tro-nic/SondaDiferencial/img/bottom.png

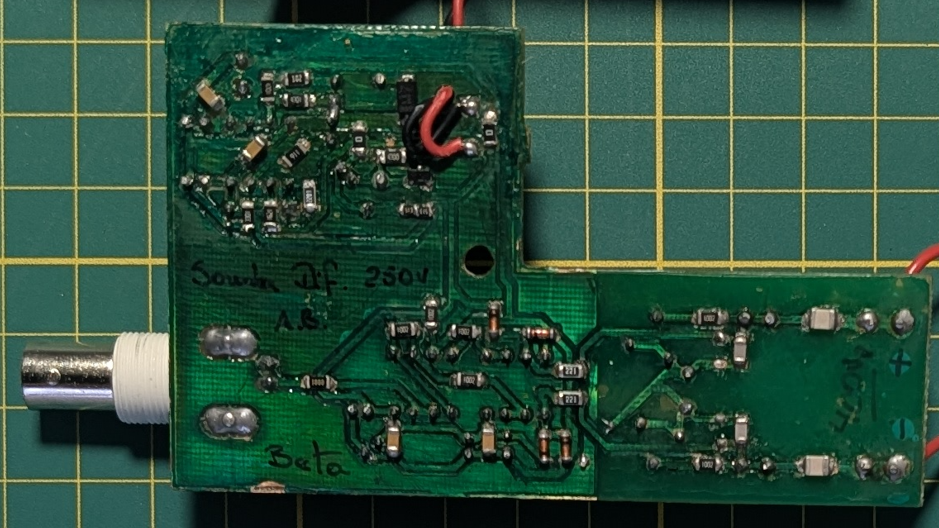
img/bottom.png
