tro-nic/SondaDiferencial/img/Regulador.png

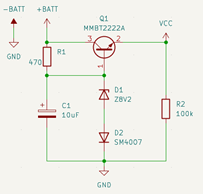
img/Regulador.png
