tro-nic/SondaDiferencial/PCB_KICAD10/sonda_diferencia_v0.kicad_pcb

## KiCad design PCB_KICAD10/sonda_diferencia_v0.kicad_pcb (2026-10-22)

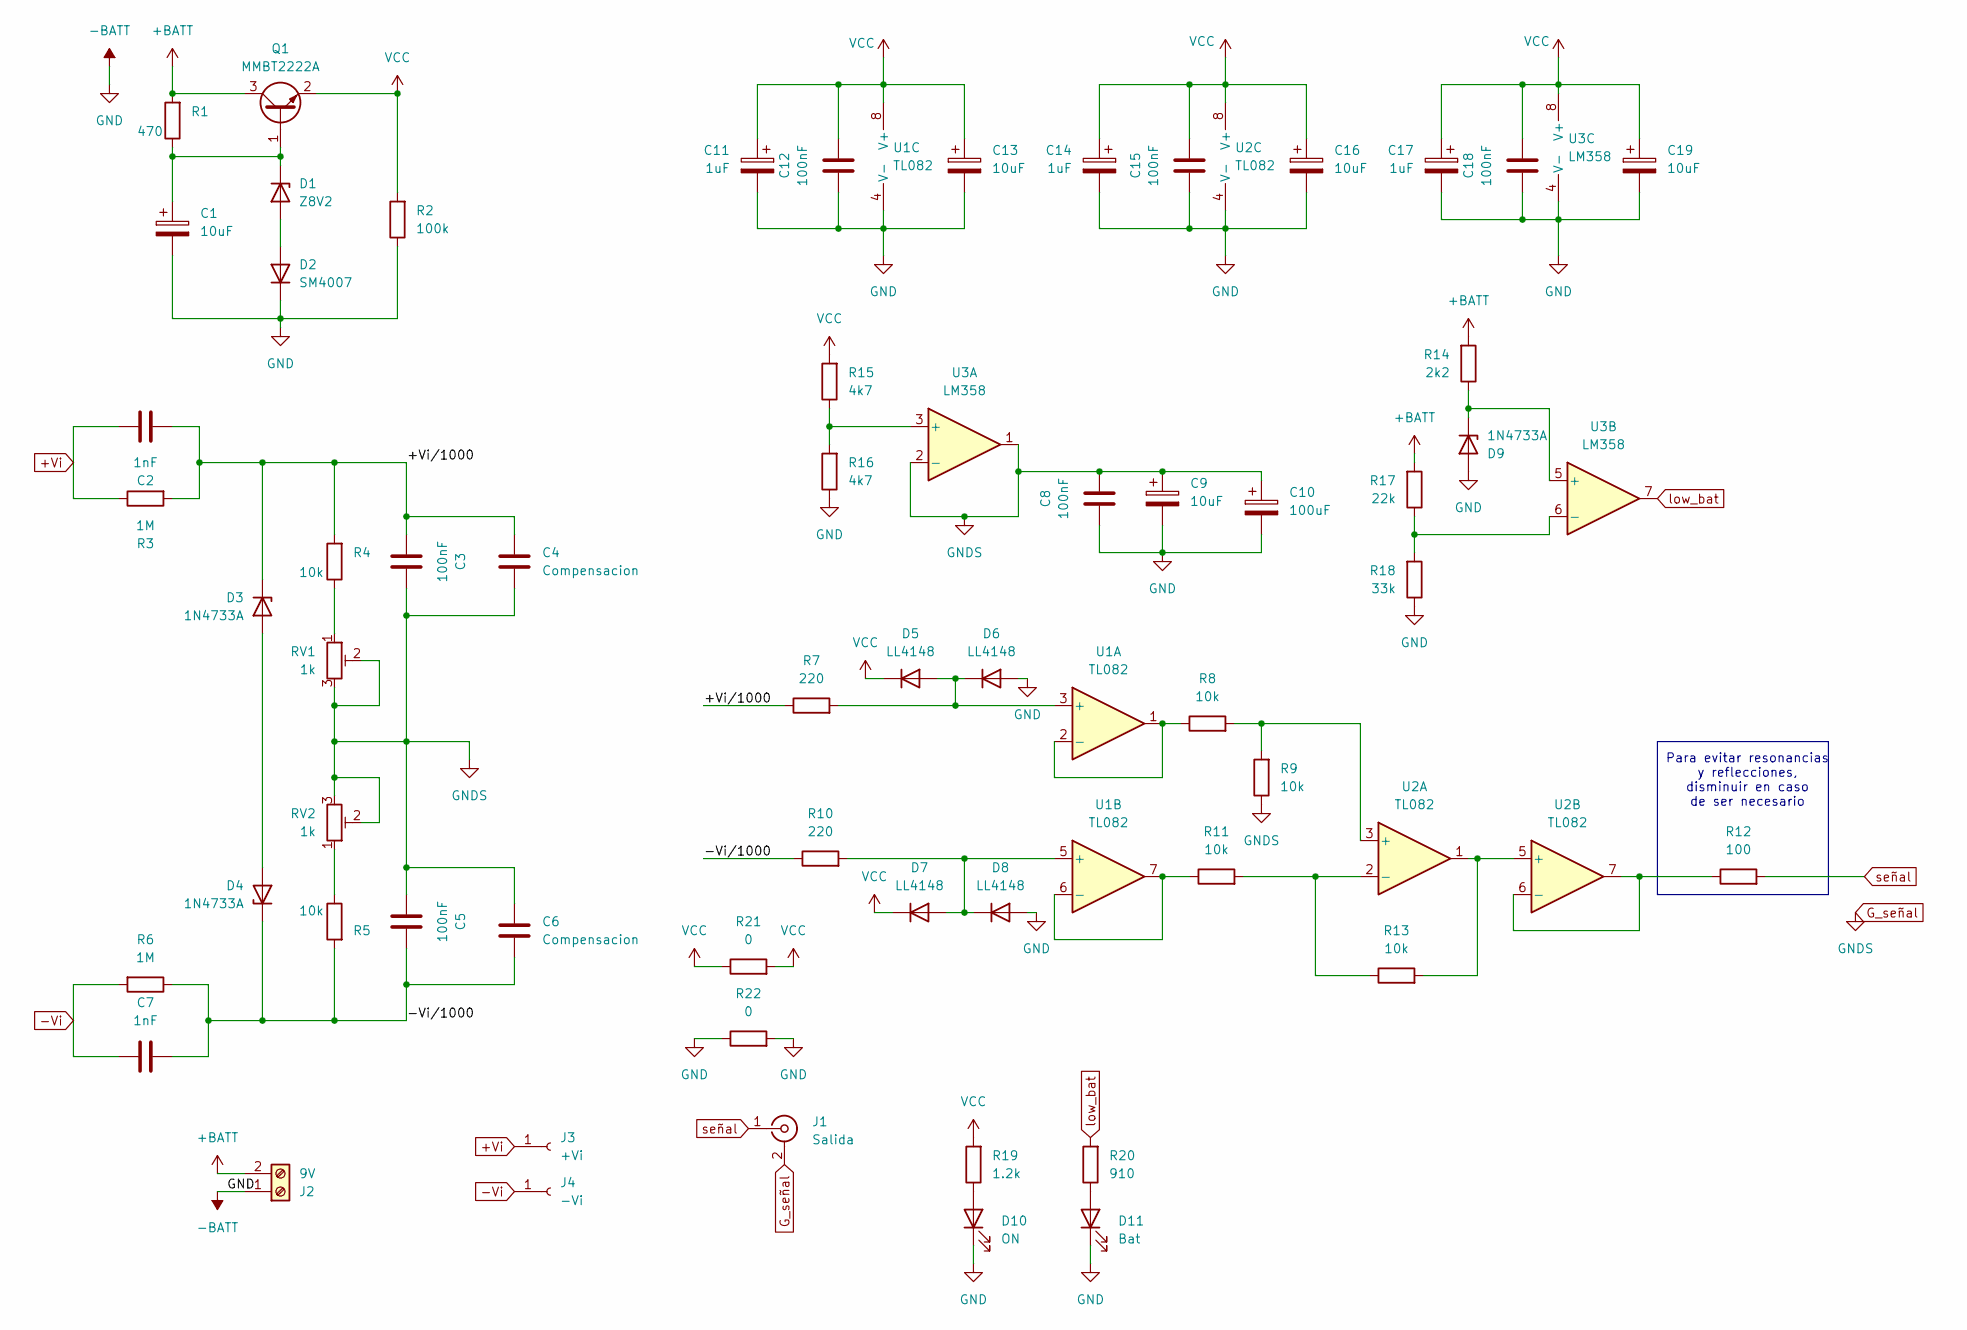
[picture p6: schematic sonda_diferencia_v0.kicad_sch, Sonda activa diferencial (DIY/Lowcost)]

Parts:
C1, C9, C13, C16, C19: 10uF; CP_Radial_D5.0mm_P2.00mm
C2, C7: 1nF; C_1206_3216Metric_Pad1.33x1.80mm_HandSolder
C3, C5, C8, C12, C15, C18: 100nF; C_1206_3216Metric_Pad1.33x1.80mm_HandSolder
C4, C6: Compensacion; C_1206_3216Metric_Pad1.33x1.80mm_HandSolder
C10: 100uF; CP_Radial_D8.0mm_P3.50mm
C11, C14, C17: 1uF; CP_Radial_D4.0mm_P2.00mm
D1: Z8V2; D_DO-41_SOD81_P12.70mm_Horizontal
D2: SM4007; D_MELF
D3, D4, D9: 1N4733A; D_DO-41_SOD81_P10.16mm_Horizontal
D5, D6, D7, D8: LL4148; D_MiniMELF
D10: ON; LED_D3.0mm
D11: Bat; LED_D3.0mm
J1: Salida; BNC_Amphenol_B6252HB-NPP3G-50_Horizontal
J2: 9V; TerminalBlock_MaiXu_MX126-5.0-02P_1x02_P5.00mm
J3: +Vi; PinHeader_1x01_P2.54mm_Vertical
J4: -Vi; PinHeader_1x01_P2.54mm_Vertical
Q1: MMBT2222A; SOT-23
R1: 470; R_1206_3216Metric_Pad1.30x1.75mm_HandSolder
R2: 100k; R_1206_3216Metric_Pad1.30x1.75mm_HandSolder
R3, R6: 1M; R_Axial_DIN0411_L9.9mm_D3.6mm_P12.70mm_Horizontal
R4, R5, R8, R9, R11, R13: 10k; R_1206_3216Metric_Pad1.30x1.75mm_HandSolder
R7, R10: 220; R_1206_3216Metric_Pad1.30x1.75mm_HandSolder
R12: 100; R_1206_3216Metric_Pad1.30x1.75mm_HandSolder
R14: 2k2; R_1206_3216Metric_Pad1.30x1.75mm_HandSolder
R15, R16: 4k7; R_1206_3216Metric_Pad1.30x1.75mm_HandSolder
R17: 22k; R_1206_3216Metric_Pad1.30x1.75mm_HandSolder
R18: 33k; R_1206_3216Metric_Pad1.30x1.75mm_HandSolder
R19: 1.2k; R_1206_3216Metric_Pad1.30x1.75mm_HandSolder
R20: 910; R_1206_3216Metric_Pad1.30x1.75mm_HandSolder
R21, R22: 0; R_1206_3216Metric_Pad1.30x1.75mm_HandSolder
RV1, RV2: 1k; Potentiometer_Piher_PT-6-V_Vertical
U1, U2: TL082; DIP-8_W7.62mm_Socket
U3: LM358; DIP-8_W7.62mm_Socket

Connections:
+BATT: J2.2, Q1.3 (C), R1.2, R14.2, R17.2
+Vi: C2.1, J3.1 (Pin_1_1), R3.1
-BATT: C1.2, C8.1, C9.2, C10.2, C11.2, C12.1, C13.2, C14.2, C15.1, C16.2, C17.2, C18.1, C19.2, D2.1 (K), D6.2 (A), D8.2 (A), D9.2 (A), D10.1 (K), D11.1 (K), J2.1, R2.1, R16.1, R18.1, R22.1, R22.2, U1.4 (V-), U2.4 (V-), U3.4 (V-)
-Vi: C7.1, J4.1 (Pin_1_1), R6.2
/+Vi/1000: C2.2, C3.2, C4.2, D3.1 (K), R3.2, R4.2, R7.1
/-Vi/1000: C5.2, C6.1, C7.2, D4.1 (K), R5.2, R6.1, R10.1
unnamed: D1.2 (A), D2.2 (A)
unnamed: C1.1, D1.1 (K), Q1.1 (B), R1.1
unnamed: D5.2 (A), D6.1 (K), R7.2, U1.3 (+)
unnamed: D7.2 (A), D8.1 (K), R10.2, U1.5 (+)
unnamed: D9.1 (K), R14.1, U3.5 (+)
unnamed: D10.2 (A), R19.1
unnamed: D11.2 (A), R20.1
unnamed: R4.1, RV1.1
unnamed: R5.1, RV2.1
unnamed: R8.1, U1.1, U1.2 (-)
unnamed: R11.1, U1.6 (-), U1.7
unnamed: R8.2, R9.2, U2.3 (+)
unnamed: R11.2, R13.1, U2.2 (-)
unnamed: R13.2, U2.1, U2.5 (+)
unnamed: R12.1, U2.6 (-), U2.7
unnamed: R15.1, R16.2, U3.3 (+)
unnamed: R17.1, R18.2, U3.6 (-)
VCC: C11.1, C12.2, C13.1, C14.1, C15.2, C16.1, C17.1, C18.2, C19.1, D5.1 (K), D7.1 (K), Q1.2 (E), R2.2, R15.2, R19.2, R21.1, R21.2, U1.8 (V+), U2.8 (V+), U3.8 (V+)
low_bat: R20.2, U3.7
señal: J1.1 (In), R12.2

Notes on the sheet:
Para evitar resonancias y reflecciones, disminuir en caso de ser necesario

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
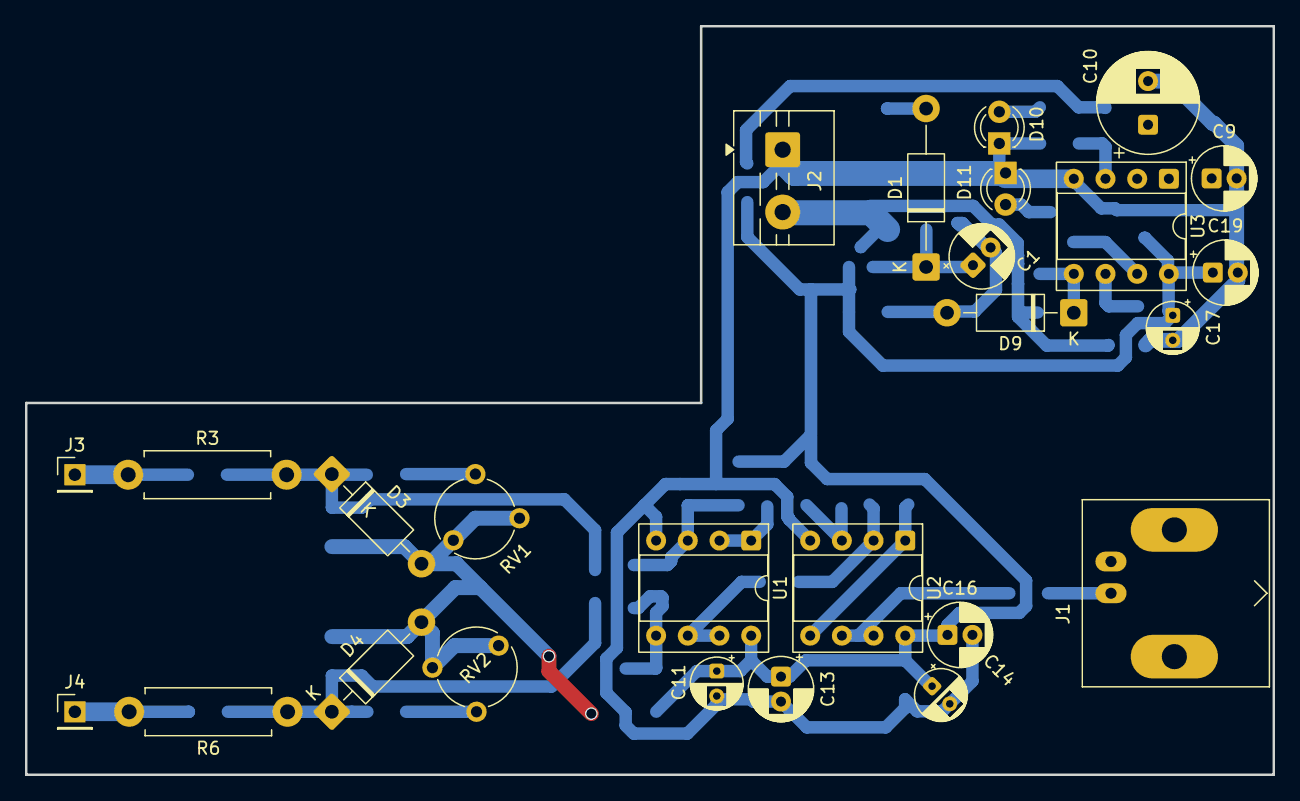
[picture p7: board sonda_diferencia_v0.kicad_pcb from above]

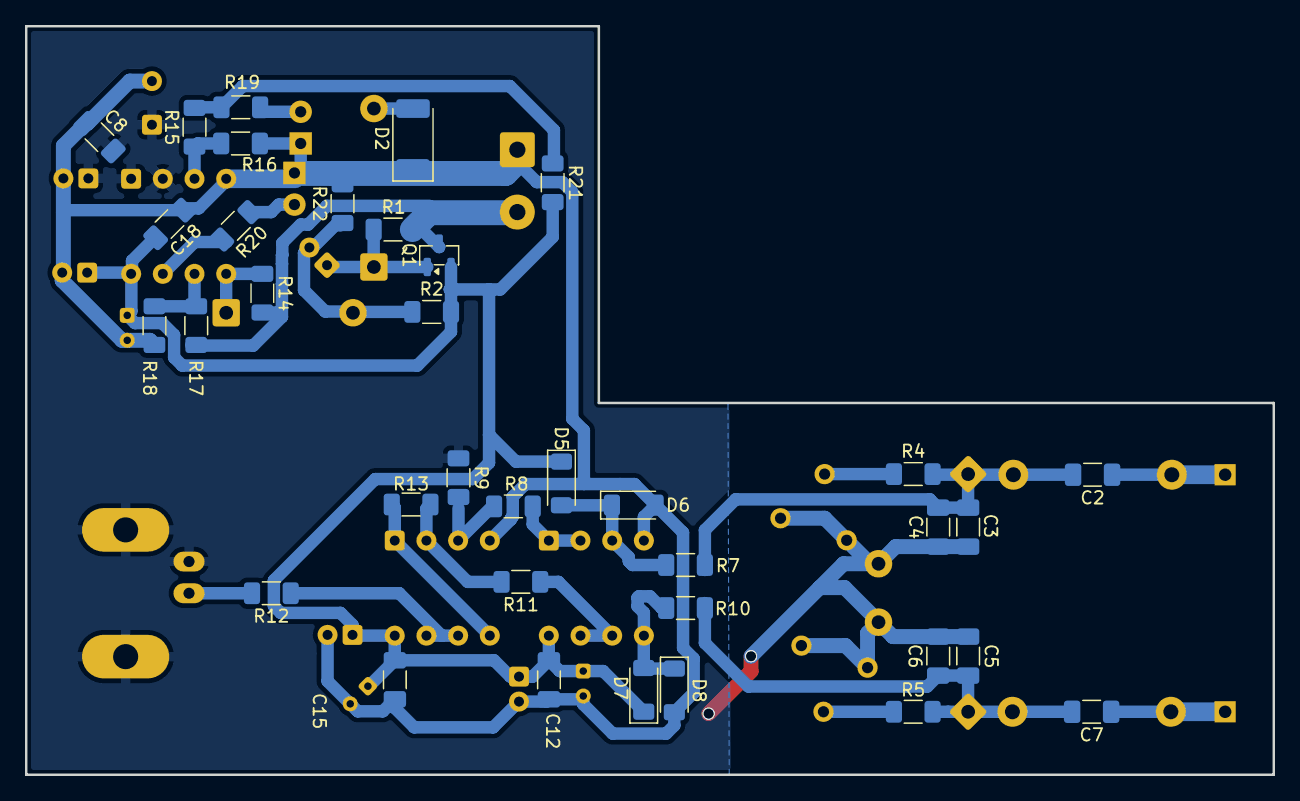
[picture p8: board sonda_diferencia_v0.kicad_pcb from below]

Board: 2 copper layers, 100.0 x 60.0 mm, 62 parts (36 on the bottom side), 27 nets.
