tro-nic/SondaDiferencial/(notices)

Notices in the files:
README.md:
Licencia: CC BY-NC-SA 3.0
